Cronvs/ZAir/README.md

DISCLAIMER: The authors of this project are not responsible for how the files are used in any capacity.

CREDIT: This work is directly derivative of the work by [AirGradient](https://www.airgradient.com/)

BUGS: Molex picoblade connector to the "pms5003" is reversed. Cable thus need to be re-crimped, or need to reverse order between sensor and connection.

### ZAir
This work is directly compatible with the [AirGradient ONE](https://www.airgradient.com/indoor/),
it was created in frustration of the size over the monitor,
and personal opinions on LED, including but not limited to screens.

It is indeed a fork of the work done by AirGradient themselves, without whom this project would not have happened.
It was redesigned in KiCAD and has been verified in production via JLCPCB.

All sensors have been integrated directly into the main board, this removes superfluous board ordering or assembly,
however, it also means that "upgrading" with new sensors is harder.
The dimensions have approximately been halved, decreasing the area to around a quarter of the original design.
More could probably be done, but inexperience, and assumptions that the people at AirGradient probably had some good
reason except just temperature made the sensor into the size it is today.

If you like this project consider buying the author(s) a coffee or two.

"Buy Me A Coffee" (https://www.buymeacoffee.com/cronvs)
