Cronvs/ZAir/production/bom.csv

Designator | Footprint | Quantity | Value | LCSC Part #
BOOT1, RESET1 | PTS525SM08SMTR2LFS | 2 | SW_Push_Dual | C92584
C1, C9 | 0603 | 2 | 0.01uf | C1589
C10, C12, C13, C17, C18, C2, C3, C4, C6, C8 | 0603 | 10 | 0.1uf | C1590
C11, C16 | 0603 | 2 | 22uf / 10V | C86295
C19 | 0603 | 1 | 100nf / 25V | C1590
C20, C21 | 0603 | 2 | 1uf | C5673
C7 | 0603 | 1 | 10uf / 25V | C96446
F1 | 1206 | 1 | 1A 16V | C70075
I2C1, I2C2, I2C3 | PinSocket_1x04_P2.54mm_Vertical | 3 | Conn_01x04
IO1, PM2 | Molex_PicoBlade_53261-0871_1x08-1MP_P1.25mm_Horizontal | 2 | Conn_01x08_MountingPin | C293349
R10, R11 | 0603 | 2 | 10K | C25804
R15 | 0603 | 1 | 4.7R | C23164
R16, R17 | 0603 | 2 | 5K | C166926
R4, R8 | 0603 | 2 | 100K | C25803
R5 | 0603 | 1 | 51K | C23196
R6, R7 | 0603 | 2 | 5.1K | C23186
S*2 | Co2-S8 | 1 | Co2-S8
U2 | SOT-23-6 | 1 | TPL5010 | C473912
U3 | XDCR_SGP41-D-R4 | 1 | SGP41-D-R4 | C3659325
U4 | SOT-223-3_TabPin2 | 1 | LM1117-3.3 | C6186
U5 | SHT4XI-DIGITAL | 1 | SHT4XI-DIGITAL | C7461846
U6 | XCVR_ESP32-C3-MINI-1-N4 | 1 | ESP32-C3-MINI-1-N4 | C2934569
USB1 | 918-418K2022Y40000 | 1 | 918-418K2022Y40000 | C168704
