Cronvs/ZAir/enclosure/ZAirShell.FCStd

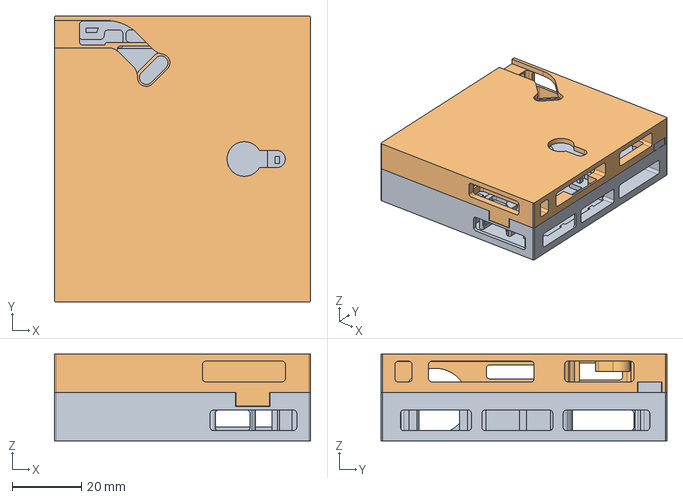
[picture p1: CAD file, 2026-01-08]
enclosure/ZAirShell.FCStd
74.0 x 82.6 x 25.0 mm
Toplock
Botlock
