Cronvs/ZAir/ZAir.kicad_pcb

## KiCad design ZAir.kicad_pcb (2025-08-03)

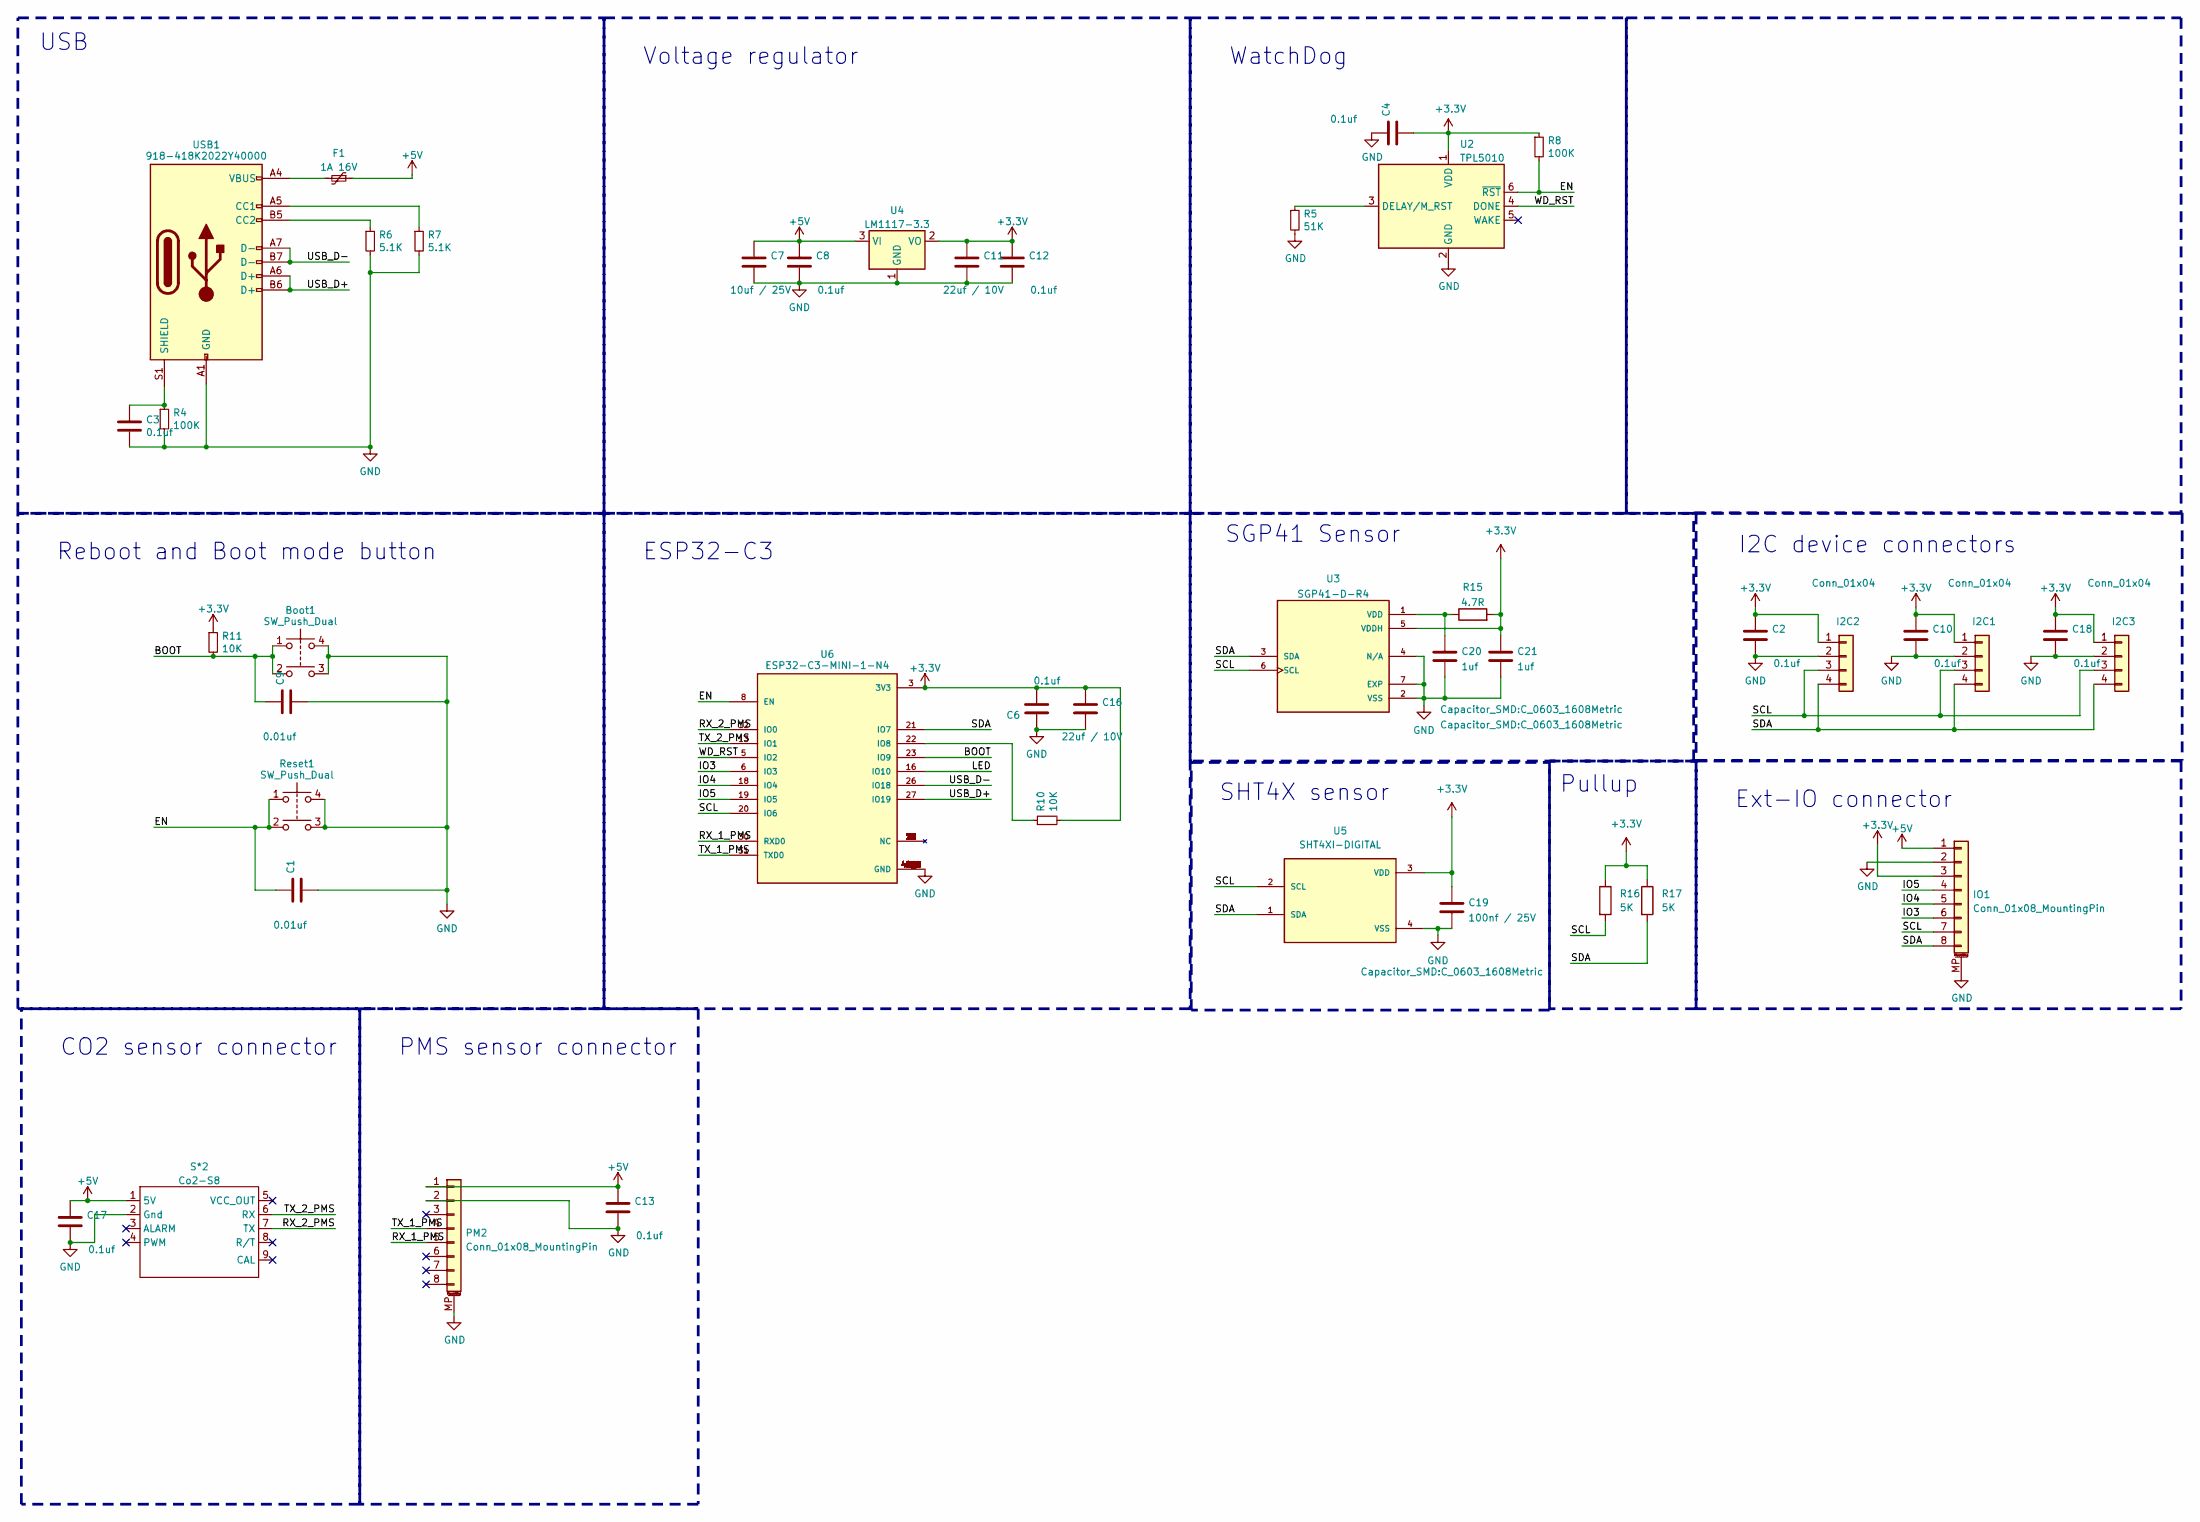
[picture p2: schematic ZAir.kicad_sch]

Parts:
Boot1: SW_Push_Dual; PTS525SM08SMTR2LFS; LCSC Part # C221855
C1, C9: 0.01uf; C_0603_1608Metric; LCSC Part # C1589
C2, C3, C4, C6, C8, C10, C12, C13, C17, C18: 0.1uf; C_0603_1608Metric; LCSC Part # C1590
C7: 10uf / 25V; C_0603_1608Metric; LCSC Part # C96446
C11, C16: 22uf / 10V; C_0603_1608Metric; LCSC Part # C86295
C19: 100nf / 25V; C_0603_1608Metric; LCSC Part # C1590
C20, C21: 1uf; C_0603_1608Metric; LCSC Part # C5673
F1: 1A 16V; Fuse_1206_3216Metric; LCSC Part # C70075
I2C1, I2C2, I2C3: Conn_01x04; PinSocket_1x04_P2.54mm_Vertical
IO1: Conn_01x08_MountingPin; Molex_PicoBlade_53261-0871_1x08-1MP_P1.25mm_Horizontal; LCSC Part # C240845
PM2: Conn_01x08_MountingPin; Molex_PicoBlade_53261-0871_1x08-1MP_P1.25mm_Horizontal; LCSC Part # C240845
R4, R8: 100K; R_0603_1608Metric; LCSC Part # C25803
R5: 51K; R_0603_1608Metric; LCSC Part # C23196
R6, R7: 5.1K; R_0603_1608Metric; LCSC Part # C23186
R10, R11: 10K; R_0603_1608Metric; LCSC Part # C25804
R15: 4.7R; R_0603_1608Metric; LCSC Part # C23164
R16, R17: 5K; R_0603_1608Metric; LCSC Part # C166926
Reset1: SW_Push_Dual; PTS525SM08SMTR2LFS; LCSC Part # C221855
S*2: Co2-S8
U2: TPL5010; SOT-23-6; LCSC Part # C473912
U3: SGP41-D-R4; XDCR_SGP41-D-R4; PARTREV 1.0; LCSC Part # C3659325
U4: LM1117-3.3; SOT-223-3_TabPin2; LCSC Part # C6186
U5: SHT4XI-DIGITAL; LCSC Part # C9900186997
U6: ESP32-C3-MINI-1-N4; XCVR_ESP32-C3-MINI-1-N4; PARTREV v1.0; LCSC Part # C2934561
USB1: 918-418K2022Y40000; LCSC Part # C168704

Connections:
+3.3V: C2.1, C4.2, C6.2, C10.1, C11.1, C12.1, C16.1, C18.1, C19.1, C21.1, I2C1.1, I2C2.1, I2C3.1, IO1.3, R8.1, R10.2, R11.1, R15.2, R16.1, R17.1, U2.1 (VDD), U3.5 (VDDH), U4.2 (VO), U5.3 (VDD), U6.3 (3V3)
+5V: C7.1, C8.1, C13.1, C17.1, F1.1, IO1.1, PM2.1, S*2.1 (5V), U4.3 (VI)
/BOOT: Boot1.1, Boot1.2, C9.1, R11.2, U6.23 (IO9)
/EN: C1.1, R8.2, Reset1.1, Reset1.2, U2.6 (~RST), U6.8 (EN)
/IO3: IO1.6, U6.6 (IO3)
/IO4: IO1.5, U6.18 (IO4)
/IO5: IO1.4, U6.19 (IO5)
/LED: U6.16 (IO10)
/RX_1_PMS: PM2.5, U6.30 (RXD0)
/RX_2_PMS: S*2.7 (TX), U6.12 (IO0)
/SCL: I2C1.3, I2C2.3, I2C3.3, IO1.7, R16.2, U3.6 (SCL), U5.2 (SCL), U6.20 (IO6)
/SDA: I2C1.4, I2C2.4, I2C3.4, IO1.8, R17.2, U3.3 (SDA), U5.1 (SDA), U6.21 (IO7)
/TX_1_PMS: PM2.4, U6.31 (TXD0)
/TX_2_PMS: S*2.6 (RX), U6.13 (IO1)
/USB_D+: U6.27 (IO19), USB1.A6 (D+), USB1.B6 (D+)
/USB_D-: U6.26 (IO18), USB1.A7 (D-), USB1.B7 (D-)
/WD_RST: U2.4 (DONE), U6.5 (IO2)
GND: Boot1.3, Boot1.4, C1.2, C2.2, C3.2, C4.1, C6.1, C7.2, C8.2, C9.2, C10.2, C11.2, C12.2, C13.2, C16.2, C17.2, C18.2, C19.2, C20.2, C21.2, I2C1.2, I2C2.2, I2C3.2, IO1.2, IO1.MP (MountPin), PM2.2, PM2.MP (MountPin), R4.2, R5.2, R6.2, R7.2, Reset1.3, Reset1.4, S*2.2 (Gnd), U2.2 (GND), U3.2 (VSS), U3.4 (N/A), U3.7 (EXP), U4.1 (GND), U5.4 (VSS), U6.1 (GND), U6.2 (GND), U6.11 (GND), U6.14 (GND), U6.36 (GND), U6.37 (GND), U6.38 (GND), U6.39 (GND), U6.40 (GND), U6.41 (GND), U6.42 (GND), U6.43 (GND), U6.44 (GND), U6.45 (GND), U6.46 (GND), U6.47 (GND), U6.48 (GND), U6.49_1 (GND), U6.49_2 (GND), U6.49_3 (GND), U6.49_4 (GND), U6.49_5 (GND), U6.49_6 (GND), U6.49_7 (GND), U6.49_8 (GND), U6.49_9 (GND), U6.50 (GND), U6.51 (GND), U6.52 (GND), U6.53 (GND), USB1.A1 (GND), USB1.A12 (GND), USB1.B1 (GND), USB1.B12 (GND)
unnamed: F1.2, USB1.A4 (VBUS), USB1.A9 (VBUS), USB1.B4 (VBUS), USB1.B9 (VBUS)
unnamed: R5.1, U2.3 (DELAY/M_RST)
unnamed: C20.1, R15.1, U3.1 (VDD)
unnamed: R10.1, U6.22 (IO8)
unnamed: R7.1, USB1.A5 (CC1)
unnamed: R6.1, USB1.B5 (CC2)
unnamed: C3.1, R4.1, USB1.S1 (SHIELD)

Notes on the sheet:
SHT4X sensor
WatchDog
CO2 sensor connector
ESP32-C3
I2C device connectors
USB
Reboot and Boot mode button
Ext-IO connector
Voltage regulator
PMS sensor connector
SGP41 Sensor
Pullup

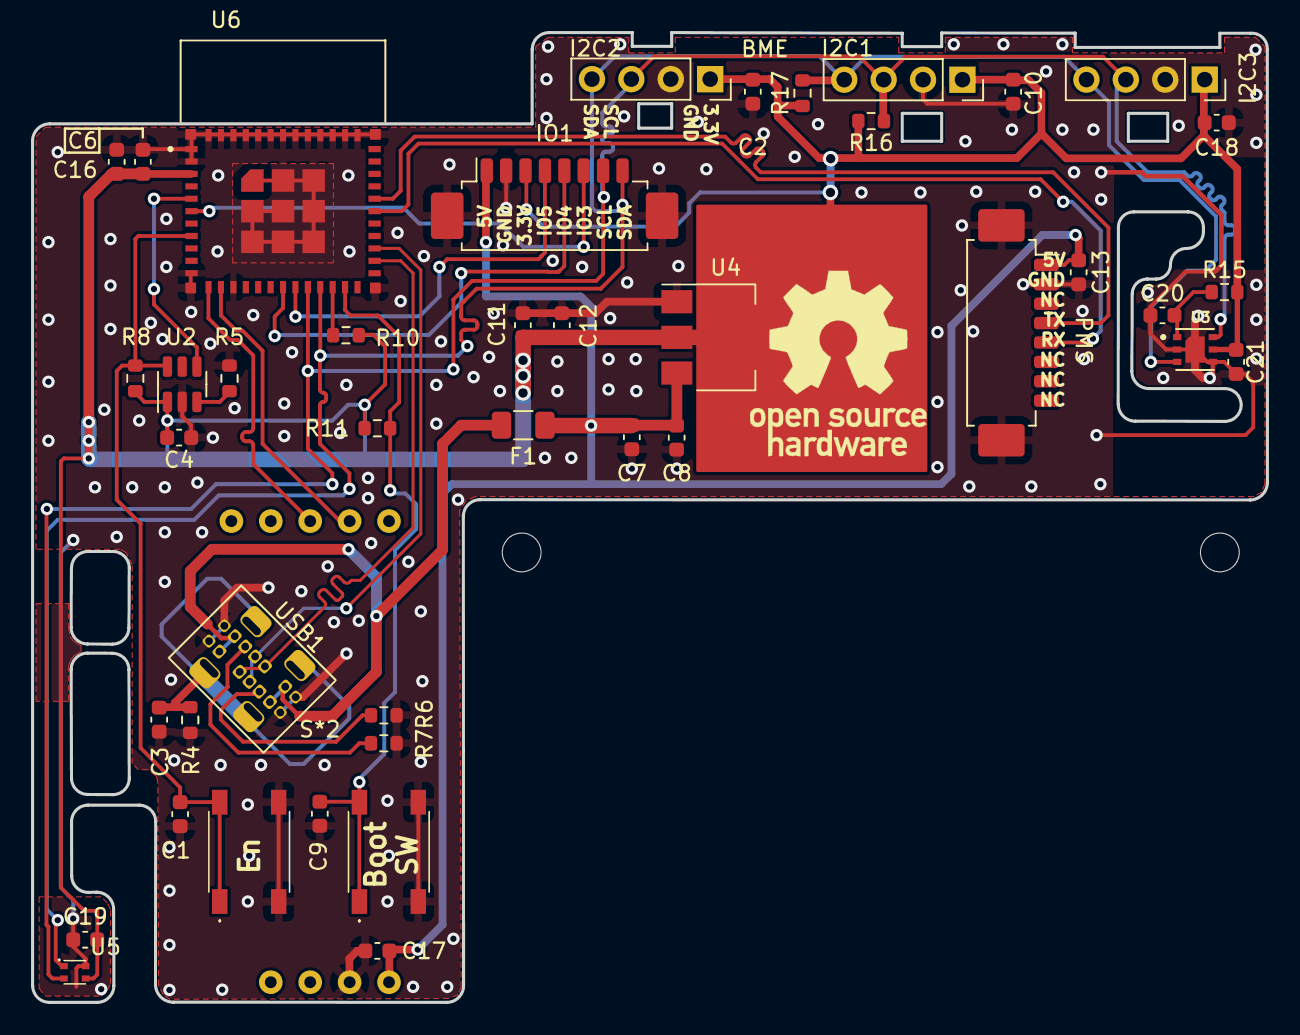
[picture p3: board ZAir.kicad_pcb from above]

Board: 2 copper layers, 79.6 x 62.5 mm, 43 parts (1 on the bottom side), 24 nets.
