Cronvs/ZAir/(commit log)

2025-11-26 known hardware bug added, nothing critical but need to fix issue in cable domain
2026-01-08 added enclosure
